yerpj/SmartWatering/Integration.jpg

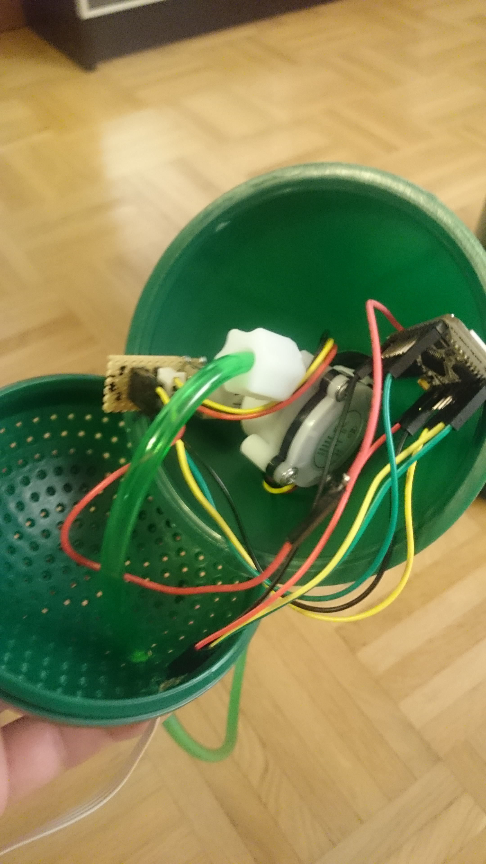
Integration.jpg
