yerpj/SmartWatering/Prototype.JPG

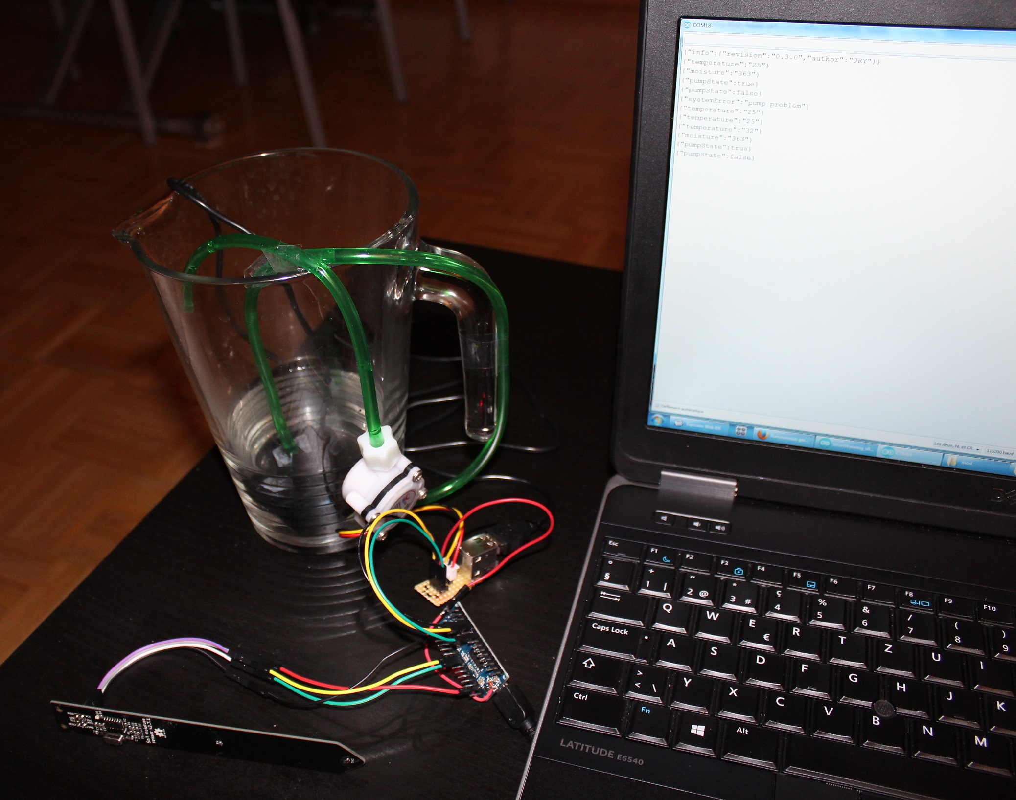
Prototype.JPG
