yerpj/SmartWatering/SmartWateringCan.jpg

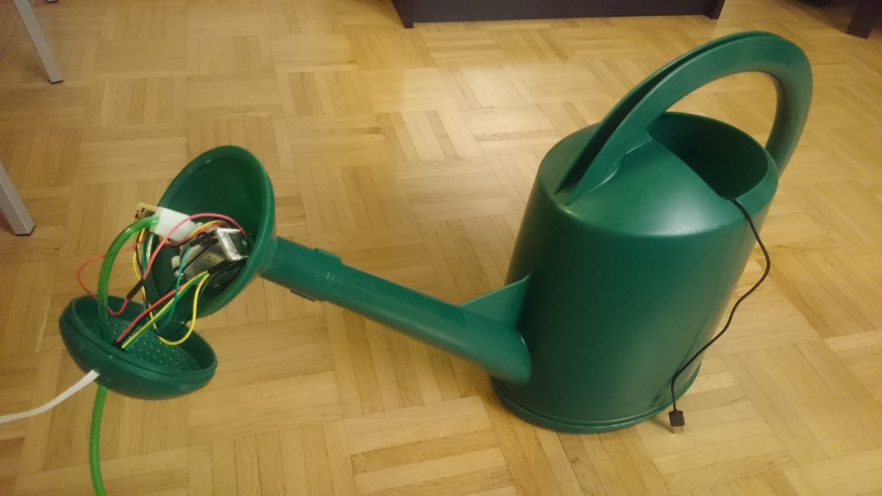
SmartWateringCan.jpg
