yerpj/SmartWatering/FinalSetup.jpg

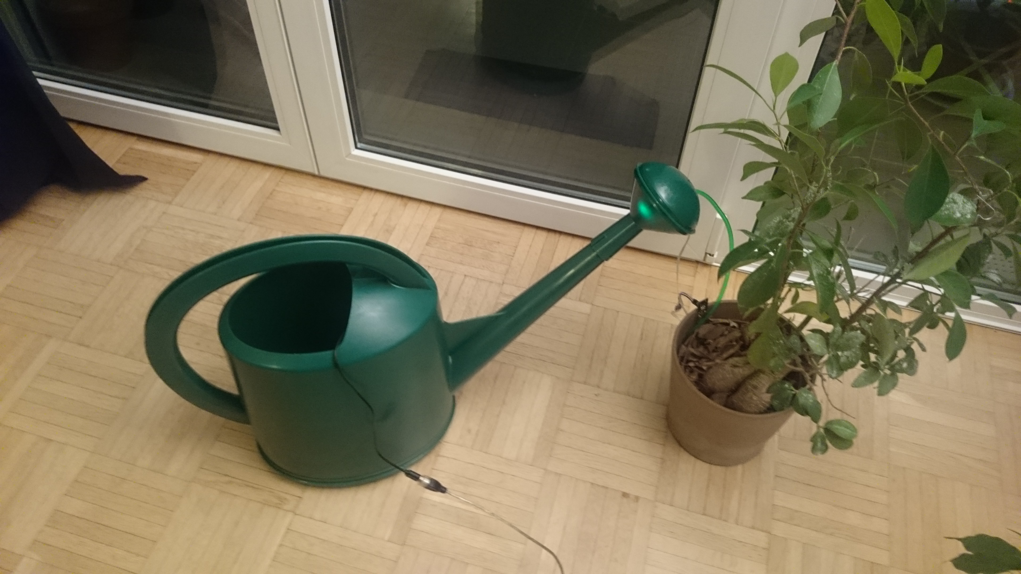
FinalSetup.jpg
