yerpj/SmartWatering/(commit log)

2016-01-06 Material image added
2016-01-06 - Added a chapter for the Arduino modification
2016-01-07 Pull-ups added on the wiring diagram
2016-01-08 - pull up added on the liquid flow sensor input - Command line interface (CLI) implemented - Readme in progress
2016-01-09 - Added timestamp on the pumpState notification
2016-01-15 Luminosity sensor is supported since version 0.4.0
2016-04-09 Successful connection to the internet through the Particle Core. A next step will be to push all the arduino code into the Particle Core instead of using both the latter and Arduino Uno.
2016-04-13 Pump pin changed from D2 to A0 (because A0 is not set to a specific voltage at power up, as opposite as D2 which seems to go to LOW until WIFI is connected)
2016-04-14 Pictures updated (Arduino Nano replaced with Particle Core)
2016-04-14 Pin name (Pump control pin) updated
2016-04-14 First working prototype. Pictures updated, Readme updated
2016-06-05 Updated readme with sample code for powershell and reference to complete script
